roberttidey/ATTinyIR/Docs/ATTinyIRSchematic.jpg

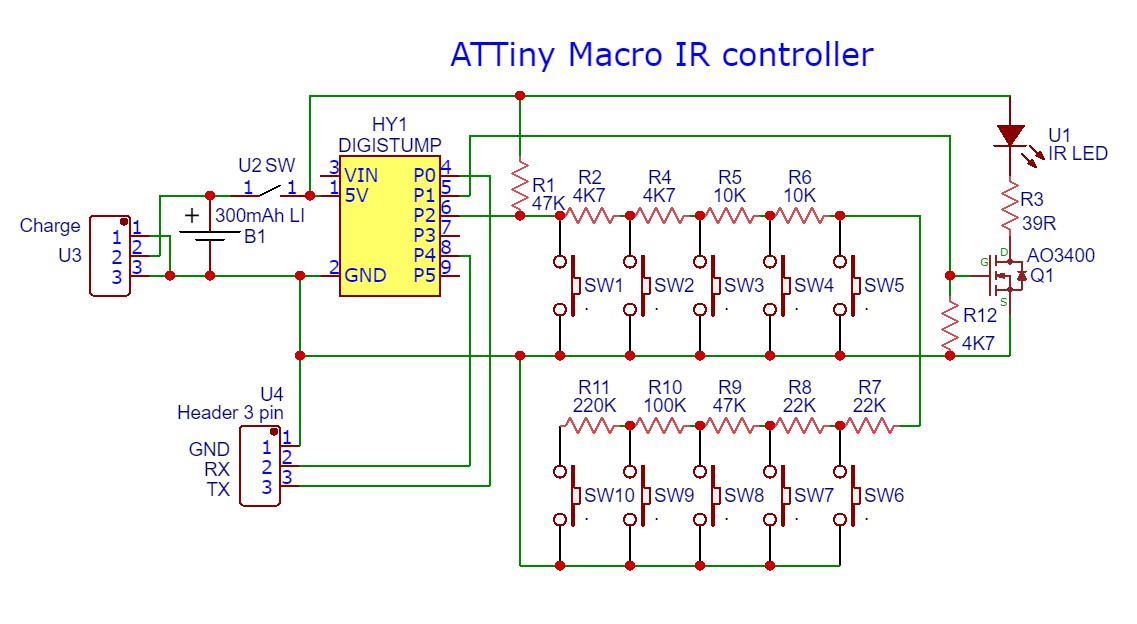
Docs/ATTinyIRSchematic.jpg
